robin7331/pixel-pump-motor-board/README.md

# Pixel Pump Motor Board Rev 5
`KiCad 6.0.11`

See iBOM [rendered as Page](https://htmlpreview.github.io/?https://github.com/robin7331/pixel-pump-motor-board/blob/main/bom/ibom.html) via GitHub Pages
