robin7331/pixel-pump-motor-board/components/250X15W104MV4E/250X15W104MV4E.step

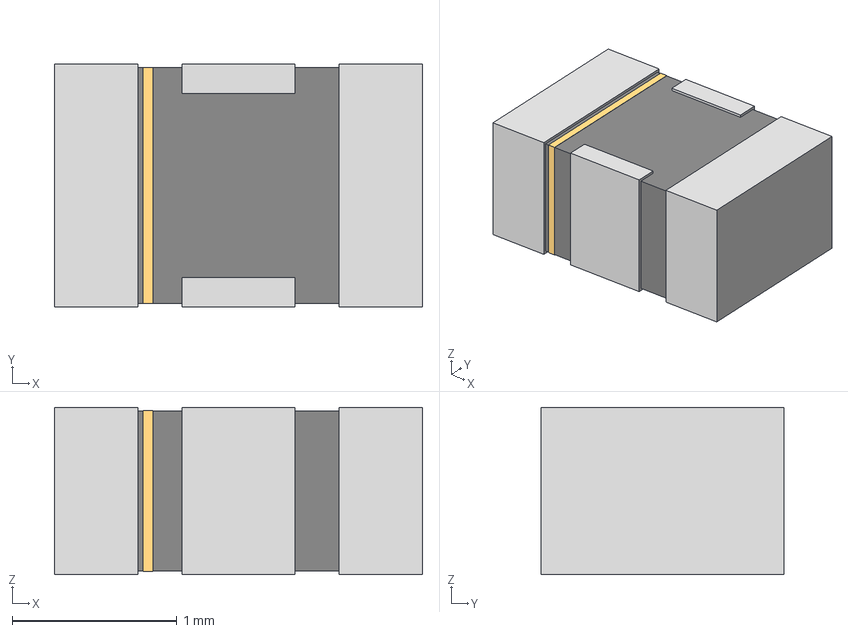
[picture p1: CAD file, 2021-08-02]
components/250X15W104MV4E/250X15W104MV4E.step
2.24 x 1.47 x 1.02 mm
