robin7331/pixel-pump-motor-board/components/STN4NF20L/STN4NF20L.step

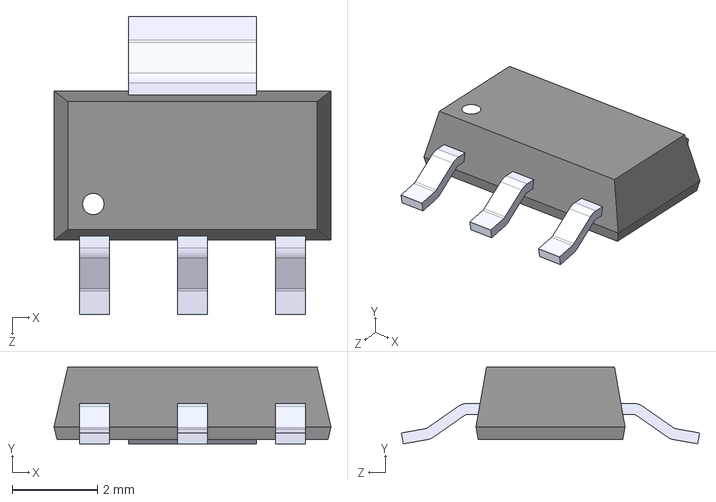
[picture p2: CAD file, 2021-08-02]
components/STN4NF20L/STN4NF20L.step
6.50 x 1.80 x 7.00 mm
