robin7331/pixel-pump-motor-board/dxf/user-drawings.dxf

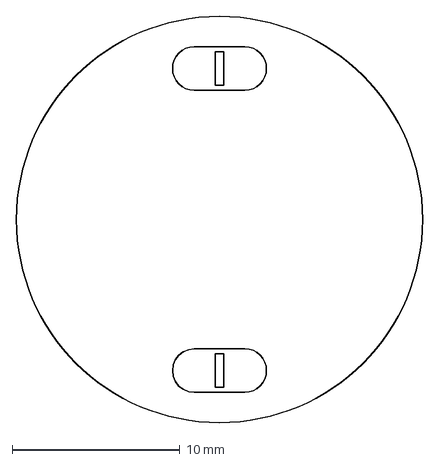
[picture p3: CAD file, 2021-08-02]
dxf/user-drawings.dxf
24.2 x 24.2 mm
