robin7331/pixel-pump-motor-board/pixel-pump-motor-board.step

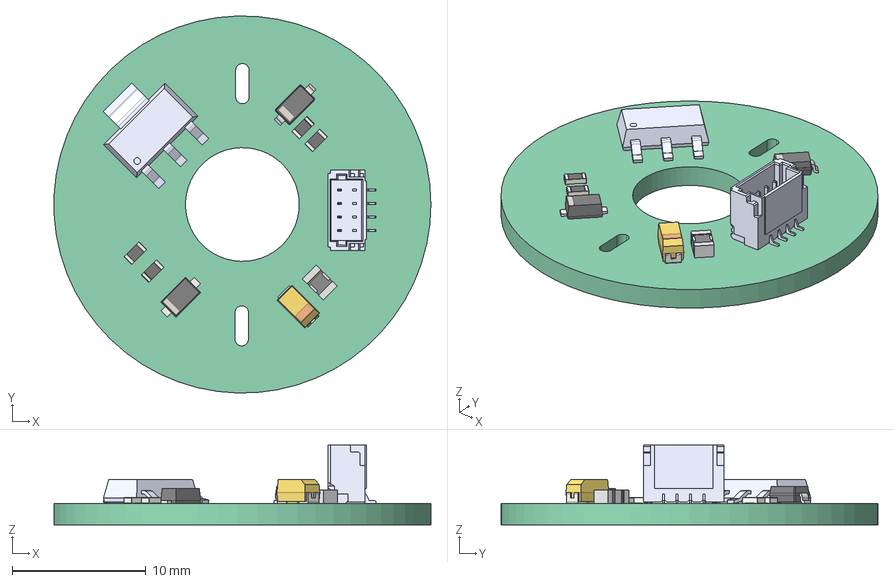
[picture p4: CAD file, 2021-08-03]
pixel-pump-motor-board.step
28.2 x 28.2 x 5.95 mm
Pcb_9d59
U1_part_634ee303dea5
Q1_LD1117S33CTR_9a871403e764
C1_CP_EIA_3216_18_Kemet_A_fbe38922cb6f
J1_BM04B-SRSS-TBT(LF)(SN)_d963deebeacb[2]
R1_R_0603_1608Metric_67cf9d6c3e10
R4_R_0603_1608Metric_81c35de960c8
R2_R_0603_1608Metric_22819df6cb3b
D2_D_SOD_123_ec3456ff0c7e
R3_R_0603_1608Metric_e2a6386c7655
D1_D_SOD_123F_95caba32a88d
