robin7331/pixel-pump-motor-board/dxf/edge-cuts.dxf

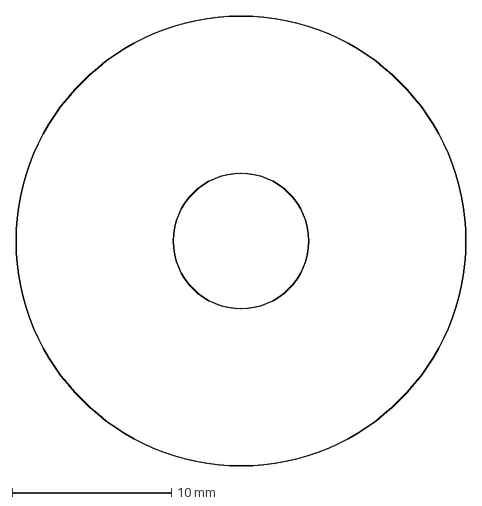
[picture p5: CAD file, 2021-08-02]
dxf/edge-cuts.dxf
28.2 x 28.2 mm
