robin7331/pixel-pump-motor-board/pixel-pump-motor-board.kicad_pcb

## KiCad design pixel-pump-motor-board.kicad_pcb (2023-02-24)

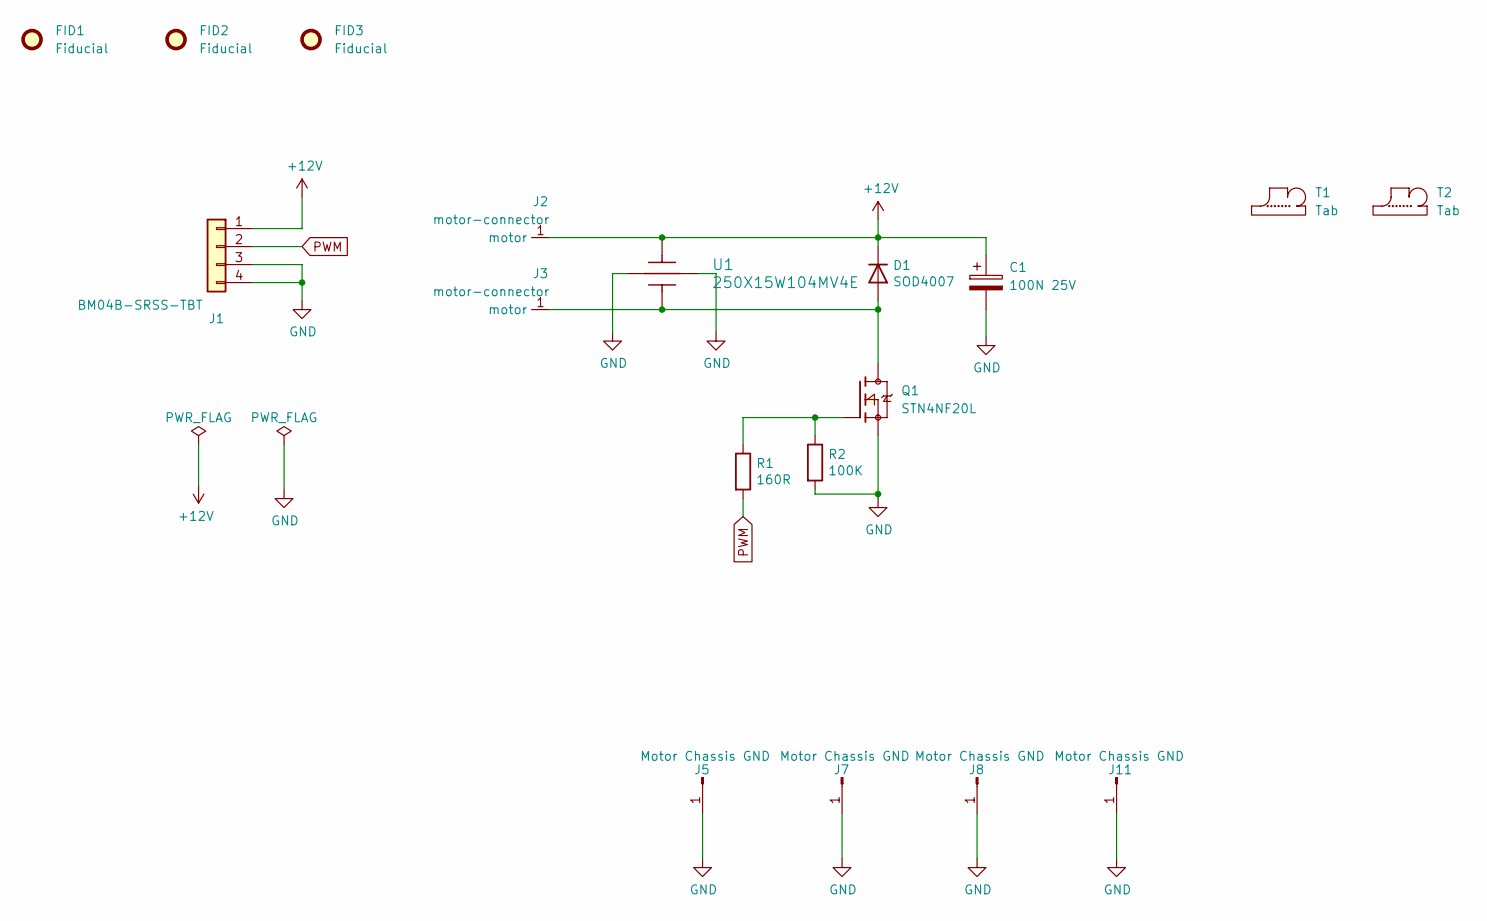
[picture p6: schematic pixel-pump-motor-board.kicad_sch]

Parts:
C1: 100N 25V; CP_EIA-3216-18_Kemet-A; MPN T491A104K035AT
D1: SOD4007; D_SOD-123F; MPN SOD4007
FID1, FID2, FID3: Fiducial; Fiducial_0.5mm_Mask1mm
J1: BM04B-SRSS-TBT; MPN BM04B-SRSS-TBT(LF)(SN)
J2, J3: motor-connector; motor-mount
J5, J7, J8, J11: Motor Chassis GND; TestPoint_Pad_2.0x2.0mm
Q1: STN4NF20L; SOT223; PARTNO 497-10779-1-ND
R1: 160R; R_0603_1608Metric; MPN 160 0603
R2: 100K; R_0603_1608Metric; MPN 100k 0603
T1, T2: Tab
U1: 250X15W104MV4E; MPN 250X15W104MV4E

Connections:
+12V: C1.1, D1.1 (K), J1.1, J2.1 (motor), U1.2
GND: C1.2, J1.3, J1.4, J5.1, J7.1, J8.1, J11.1, Q1.3, R2.2, U1.3, U1.4
unnamed: D1.2 (A), J3.1 (motor), Q1.2, Q1.T, U1.1
unnamed: Q1.1, R1.1, R2.1
PWM: J1.2, R1.2

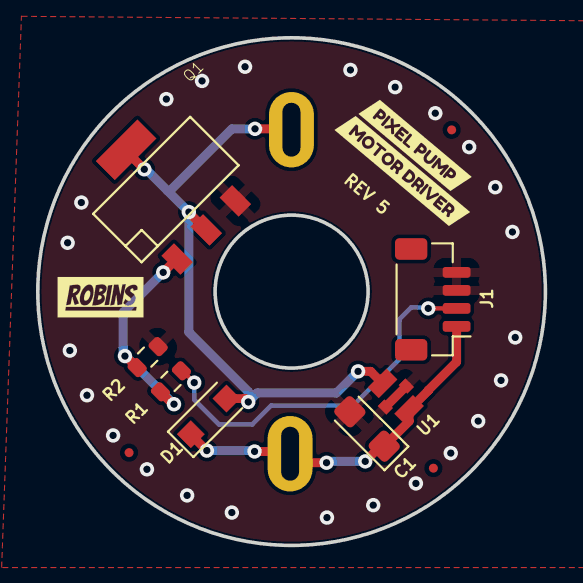
[picture p7: board pixel-pump-motor-board.kicad_pcb from above]

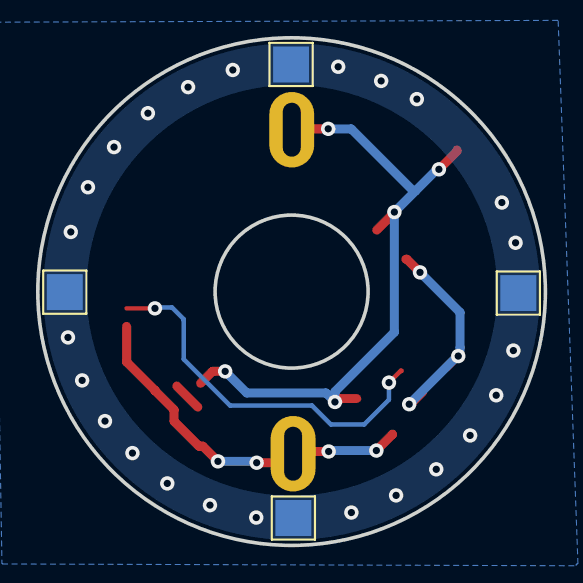
[picture p8: board pixel-pump-motor-board.kicad_pcb from below]

Board: 2 copper layers, 28.2 x 28.2 mm, 20 parts (4 on the bottom side), 5 nets.

Other parts of the board:
kibuzzard-62EBC13F: G***; kibuzzard-62EBC13F
kibuzzard-62EBC161: G***; kibuzzard-62EBC161
