robin7331/pixel-pump-motor-board/(threads)

Thread 1 (2023-02-01):

PCB idea

oscarpeters, 2023-02-01:
Hi Robin, love the project going to order one this week.

But regarding the PCB I would like to ask a question about the use of these via's while a direct connection can be made :)
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

another thing I would advise is the use of Reliefs for PTH components
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

There is also a GND via which goes to nowhere
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

kind regards,
Oscar

robin7331, 2023-02-01:
Hey Oscar!

> But regarding the PCB I would like to ask a question about the use of these via's while a direct connection can be made :)

Adding those vias was intentional. The top layer is GND and is used to shield the backside of the motor since this board is soldered directly to it. I am trying to ke
ep the top layer intact as much as I can. It becomes a little more clear when looking at the front CU layer only.

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

> another thing I would advise is the use of Reliefs for PTH components

Whats the reason for it? If I do that I lose the regular thermal relief.

> There is also a GND via which goes to nowhere

Good catch! Removed it :)

oscarpeters, 2023-02-01:
Thermal relief is only necassary for through hole components were there is a lot of copper which have to be heated. For the best overall performance of decoupling and such, is to get as low inductance in your path, so thermal reliefs should only be used for through hole components.
