robin7331/pixel-pump-motor-board/(commit log)

2021-08-02 Step export
    [pixel-pump-motor-board.step]
2021-08-03 Finish motor board
    [pixel-pump-motor-board.kicad_pcb, pixel-pump-motor-board.kicad_sch]
2021-08-03 Cleanup and generate iBOM
    [pixel-pump-motor-board.kicad_pcb, pixel-pump-motor-board.kicad_sch, pixel-pump-motor-board.step]
2021-08-06 Minor adjustments and iBOM generation
    [pixel-pump-motor-board.kicad_pcb, pixel-pump-motor-board.kicad_sch]
2021-08-06 Generate rev2 gerbers
    [pixel-pump-motor-board-B_Cu.gbr, pixel-pump-motor-board-B_Mask.gbr, pixel-pump-motor-board-B_Paste.gbr, pixel-pump-motor-board-B_Silkscreen.gbr, pixel-pump-motor-board-Edge_Cuts.gbr, pixel-pump-motor-board-F_Cu.gbr, pixel-pump-motor-board-F_Mask.gbr, pixel-pump-motor-board-F_Paste.gbr]
2022-01-11 Upgrade project to Kicad 6
    [pixel-pump-motor-board.kicad_pcb, pixel-pump-motor-board.kicad_sch]
2022-02-18 Generate iBOM
    [pixel-pump-motor-board.kicad_sch]
2022-04-29 Fix bemf pin
    [pixel-pump-motor-board.kicad_pcb, pixel-pump-motor-board.kicad_sch]
2022-04-29 Revision bump
    [pixel-pump-motor-board.kicad_pcb]
2022-08-04 Remove bemf and add robins logo
    [pixel-pump-motor-board.kicad_pcb, pixel-pump-motor-board.kicad_sch]
2022-08-04 Bump rev
    [pixel-pump-motor-board.kicad_pcb, pixel-pump-motor-board.kicad_sch]
2022-12-04 Update val to BM04B
    [pixel-pump-motor-board.kicad_pcb, pixel-pump-motor-board.kicad_sch]
2023-01-30 Add fiducials, fix SMD/THT, Bump rev to 4
    [pixel-pump-motor-board.kicad_pcb, pixel-pump-motor-board.kicad_sch]
2023-01-31 Add 3rd fiducial
    [pixel-pump-motor-board.kicad_pcb, pixel-pump-motor-board.kicad_sch]
2023-02-01 Remove unneeded VIA
    [pixel-pump-motor-board.kicad_pcb, pixel-pump-motor-board.kicad_sch]
2023-02-13 Remove gerbers from gitignore
2023-02-13 Add kikit tabs
    [pixel-pump-motor-board.kicad_pcb, pixel-pump-motor-board.kicad_sch]
2023-02-13 Add tabs to schematics
    [pixel-pump-motor-board.kicad_sch]
2023-02-13 Update panel and gerbers for 3 x 3
    [pixel-pump-motor-board-panel-CmtUser.gbr, pixel-pump-motor-board-panel-EdgeCuts.gm1, pixel-pump-motor-board-panel-MaskBottom.gbs, pixel-pump-motor-board-panel-MaskTop.gts, pixel-pump-motor-board-panel-PasteBottom.gbp, pixel-pump-motor-board-panel-PasteTop.gtp, pixel-pump-motor-board-panel-SilkBottom.gbo, pixel-pump-motor-board-panel-SilkTop.gto]
2023-02-23 Fixed footprints
    [pixel-pump-motor-board.kicad_pcb, pixel-pump-motor-board.kicad_sch]
2023-02-24 Add BM04B footprint
    [BM04B-SRSS-TB-LF--SN---3DModel-STEP-56544.STEP, pixel-pump-motor-board.kicad_pcb, pixel-pump-motor-board.kicad_sch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]
2023-03-10 Finalized adjusted CSV file
    [pixel-pump-motor-board-top-pos-adjusted.csv]
2023-03-10 Fixed connector translation issue and created new panels
    [pixel-pump-motor-board-panel-CmtUser.gbr, pixel-pump-motor-board-panel-CuBottom.gbl, pixel-pump-motor-board-panel-CuTop.gtl, pixel-pump-motor-board-panel-EdgeCuts.gm1, pixel-pump-motor-board-panel-MaskBottom.gbs, pixel-pump-motor-board-panel-MaskTop.gts, pixel-pump-motor-board-panel-PasteBottom.gbp, pixel-pump-motor-board-panel-PasteTop.gtp]
